beepnl/beep-base-firmware/2022_10_14_BeepBase_V1.5.12/README.md

BEEP base 1.5.12 adds a fix for the timing between lora network connection attempts, fixing excessive battery drain when the lora network is unavailable. It also contains a fix for updating the BEEP base firmware by older Android phones.
