beepnl/beep-base-firmware/2020_10_12_BeepBase_V1.5.2/ReadMe.txt

2020_10_12 Release van versie 1.5.2
	Oude BLE commandos van 1.4.2 voor de tilt sensor configuratie hersteld en de BLE aan/uit en reedswitch commando's aangepast naar andere waardes.
	Tilt en reed switch commando's om de applicatie aan en uit te kunnen schakelen zijn nu gesplits naar aparte commando's.
	
		Terug:
		19d/0x13 - READ_SQ_MIN_STATE: bit[0]:1=uit, 0=aan
		147d/0x93 - WRITE_SQ_MIN_STATE
		
		Aangepast:
		READ_ONOFF_CONTROL is nu READ_REED_STATE  	  38d/0x26  bit[0]:1=uit, 0=aan
		WRITE_ONOFF_CONTROL is nu READ_ONOFF_CONTROL  166d/0xA6  bit[0]:1=uit, 0=aan
		READ_ON_STATE 39/0x27	 bit[0]:0=uit, 1=aan
		WRITE_ON_STATE 167/0xA7	 bit[0]:0=uit, 1=aan  
	
	Nog een fout gevonden in de firmware versie naar uint32_t conversie die enkel de major revisie gebruikte in plaats van ook de minor en sub revisie getallen.
		Hierdoor is het updaten met minor of sub revisies mogelijk eerder niet altijd correct gegaan, maar bij major revisies wel. Deze fout zat al heel lang in
		de code.

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
