beepnl/beep-base-firmware/2021_03_30_BeepBase_V1.5.6/ReadMe.txt

2021-03-30 Releas van versie 1.5.6
	-	Read flash commando 0x22 geeft nu status 0xE0F/3599d (End Of File) als response als het flash compleet is uitgelezen. Vorrheen was dit NRF_SUCCESS 0x0 Dit had ik gewijzigd
		tijdens het testen, omdat er een probleem was met herhalende response codes en er op verschillende plekken in de code de NRF_SUCCESS kon worden gegenereerd.
	
	-	BLE MTU size wordt nu door de BEEP karakteristiek gebruikt om de grote van een BLE bericht te limiteren, zodat het uitlezen van het flash niet standaard de maximale MTU size 
		gebruikt. Hierdoor zou het onder IOS nu ook goed moeten werken. Ik kon niet verder testen dan dat de MTU size goed stond, aangezien de nRF Connect app op IOS compleet andere
		logs genereerd.
		
	-	De Beep control point gebruikt nu een Queue. Hiermee worden berichten die naar de smartphone moeten worden gestuurd tijdelijk gebufferd. De queue kan maximaal
		4 berichten bufferen. Hiermee is het probleem dat er onder sommige situaties een vorige response code wordt herhaald verholpen.
		
	-	Flash clear commando 0x2100 werkt nu correct. Het flash wordt na het wissen opnieuw geinitialiseerd. Het flash reageerd hierna weer correct op commando's 0x22(get flash size) 
		en 0x20(read flash).

2021-03-15 Release van versie 1.5.5.
	-	Optimalizatie van de flash applicatie statemachine verlaagd waardoor het flash uitlezen ook correct werkt onder release builds. Bij eerdere firmware releases stopte de 
		statemachine doordat er een boolean werd gewist na een specifiek aantal berichten. Hiervoor geen duidelijke oorzaak gevonden dan dat met een lager optimalizatie niveau
		dan optimize for size het probleem niet meer optreed.
	
2021-03-12 Release van versie 1.5.4.
	-	Om de log uit te lezen moet een power reset niet meer nodig zijn.
	
	-	TX karakteristiek hoeft nu niet meer notificatie uit->aan te worden gezet als er wordt verbonden met een gebond apparaat. De notificatie staat wordt dan uit de 
		BLE stack gehaald.
	
	-	Als een flash commando niet wordt uitgevoerd, wordt er nu een error code terug gestuurd:
			NRF_ERROR_INVALID_STATE		Als de TX notificaties niet aan staan voor het uitlezen van het MX flash.
			NRF_ERROR_BUSY				Als de flash applicatie statemachine bezig is met een vorig commando.
			NRF_ERROR_INVALID_ADDR		Als er een invalide flash commando wordt gegeven.
		Dit moet ook voorkomen dat als het flash niet wordt uitgelezen en er geen staat of error code terug wordt gestuurd de BLE in een staat komt waarbij er geen nieuwe 
		berichten meer worden afgehandeld. Aan de smartphone kant resulteerde dit in de nRF connect App in GATT ERROR 128: No resources
		
	-	Ik kan met een kleine log file van 16879 bytes dit correct uitlezen en het aantal bytes komt overeen met de flash size die wordt uitgelezen met commando 0x22

2021_02_02 Release van versie 1.5.3
	Hotfix voor BLE commando om het flash uit te lezen, wat niet wilde starten vanwege compiler optimalisatie. Met logging aan werkte dit wel naar behoren. 

2020_10_12 Release van versie 1.5.2
	Oude BLE commandos van 1.4.2 voor de tilt sensor configuratie hersteld en de BLE aan/uit en reedswitch commando's aangepast naar andere waardes.
	Tilt en reed switch commando's om de applicatie aan en uit te kunnen schakelen zijn nu gesplits naar aparte commando's.
	
		Terug:
		19d/0x13 - READ_SQ_MIN_STATE: bit[0]:1=uit, 0=aan
		147d/0x93 - WRITE_SQ_MIN_STATE
		
		Aangepast:
		READ_ONOFF_CONTROL is nu READ_REED_STATE  	  38d/0x26  bit[0]:1=uit, 0=aan
		WRITE_ONOFF_CONTROL is nu READ_ONOFF_CONTROL  166d/0xA6  bit[0]:1=uit, 0=aan
		READ_ON_STATE 39/0x27	 bit[0]:0=uit, 1=aan
		WRITE_ON_STATE 167/0xA7	 bit[0]:0=uit, 1=aan  
	
	Nog een fout gevonden in de firmware versie naar uint32_t conversie die enkel de major revisie gebruikte in plaats van ook de minor en sub revisie getallen.
		Hierdoor is het updaten met minor of sub revisies mogelijk eerder niet altijd correct gegaan, maar bij major revisies wel. Deze fout zat al heel lang in
		de code.

2020_10_08 Release van versie 1.5.1
	Tilt schakelaar functionaliteit terug gebracht en opstart logic aangepast aan de combinatie van reedswitch en tilt switch.
		Nieuw BLE commando's READ_ONOFF_CONTROL (0x26) en WRITE_ONOFF_CONTROL toegevoegd (0xA6), waarmee de reedswitch en til switch ingesteld kunnen worden. Standaard
		staat na het programmeren met 1.5.1 of via DFU van een oudere versie altijd de reedswitch aan. Met de ONOFF_CONTROL commando's kan de reedswitch of de tilt switch
		worden ingesteld. 
	
		Beide tegelijkertijd kan ook, maar beveel ik niet aan, aangezien de aan-uit staten dan niet meer kloppen of conflicteren. De tilt sensor is dominant bij het bepalen 
		van de aan/uit staat. Bijvoorbeeld met de reedswitch de BEEPBASE inschakelen wanneer deze verticaal staat gaat goed totdat er een oriëntatie wijziging plaatst vindt 
		die door de tilt schakelaar wordt gemeten. Als de BEEPBASE wordt uitgeschakeld wanneer deze horizontaal is, zal de BEEPBASE weer actief worden wanneer die ontwaakt 
		door een kleine trilling gemeten met de tilt sensor.
		
		De reedswitch kan nog wel worden bekrachtigd om BLE adverteren te starten of de pincode te resetten wanneer de reedswitch is uitgeschakeld om de applicatie aan of 
		uit te schakelen.
	
	Het inschakelen met de reedswitch duurt nu nog maar 3 seconden in plaat van 10.

2020_09_16 Release van Versie 1.5.0
	SQ-MIN-645B Tiltschakelaar functionaliteit verwijderd, omdat die niet meer op de hardware zit voor de volgende productie batches.
		In en uitschakelen van de BEEP applicatie kan nu met de reedswitch worden uitgevoerd. Door de reedswitch voor 10 seconden te bekrachtigen kan de BEEPBASE aan of uit worden gezet
		met audio feedback voor de gebruiker. Elke seconde wordt er een pieptoon gemaakt met de buzzer die op of afloopt que frequentie, totdat die driemaal piept. Als de magneet dan
		wordt verwijderd veranderd de BEEPBASE van staat met de reeds bekende pieptonen. 
		Via BLE of LoRaWAN kan de BEEPBASE ook worden uitgezet met commando READ_ON_STATE 0x13 en WRITE_ON_STATE 0x93, voorheen gebruikt om de SQ-MIN-645B functionaliteit in of uit te
		schakelen.
	De bootloader activatie tijdens een reset met de reedswitch is nu uitgeschakeld, omdat de bootloader continue activeerde bij elke poging om de applicatie te starten van uit-staat.
	Epoch tijd toegevoegd, deze werkt enkel wanneer de BEEPBASE aanstaat. In de uitstaat zijn alle timers en klokken uitgeschakeld en kan de tijd niet bijgehouden worden.
		De tijd kan gelezen en geschreven worden via BLE of LoRaWAN en wordt ook als een parameter toegevoegd aan alle logs. READ_TIME 0x25, WRITE_TIME 0xA5.
		Als de tijd wordt gewijzigd wordt er een extra bericht gelogd in het flash met de oude en nieuwe tijd instellingen.
		Standaard staat de Epoch tijd op 0.
		Om de 48 uur wordt de tijd ook opgeslagen in het flash van de nRF als er niet eerder een flash opslag plaats vindt.
	Als de BEEPBASE wordt geprogrameerd staat deze altijd uit. Bij een firmware update is de BEEPBASE aan-staat altijd aan.
	Opstart logica is aangepast, omdat de tilt-schakelaar de nRF niet meer wakker kan maken door trillingen en orientatie wijzigingen.
	Documentatie is bijgewerkt aan bovenstaande aanpassingen.

2020_06_05 Release van Versie 1.4.2
	LoRaWAN offtime voor KPN netwerk verbeterd. De tijd berekening was niet correct wanneer de app_timer's RTC1 overflowde.

2020_06_02 Release van Versie 1.4.1
	LoRaWAN send functie gebruikte een verkeerde bericht lengte om te controleren of dat de MAC buffer verstuurd moest worden. Bij KPN LoRaWAN netwerk gaf dit problemen, omdat de MAC buffer niet
	werd verstuurd, maar er werden ook geen LoRaWAN berichten verstuurd.

2020_05_19 Release van Versie 1.4.0
	Commando geimplementeerd om de SQ-200-MIN orientatie bepaling in of uit te schakelen. Met commando READ_SQ_MIN_STATE (19d/0x13) en WRITE_SQ_MIN_STATE (147d/0x93) kan de SQ orientatie worden uitgeschakeld door bit 0 op 1 te 
	zetten. Alle andere bits worden wel opgeslagen, maar hebben geen verdere functie.

2020_02_26 Release van Versie 1.3.5
	De DS18B20 communicatie fout teller wordt nu gereset bij een nieuwe staat of conversie start. Voorheen gebeurde enkel na het succesvol uitlezen van de temperatuur. Dit had als gevolg dat als een DS18B20 
	meer dan 5 communicatie fouten had, dan stopte de sensor met meten bij oudere firmware.
	
	Bij de conversie start wordt nu de laatst gemeten temperatuur op -100.0 gezet, dus als de sensor niet uitgelezen kan worden zal die waarde worden verstuurd met LoRaWAN in plaats van de laatst gemeten waarde.

2020_01_28 Release van Versie 1.3.4
	READ_APPLICATION_CONFIG data toegevoegd aan het opstart bericht.
	
	Een minuut na het succesvol verbinden met het LoRaWAN netwerk wordt het opstart bericht verstuurd. Mocht dit niet lukken in verband met de duty cycle wordt dit 
		een minuut later opnieuw geprobeerd.

2020_01_28 Release van Versie 1.3.3
	Standaard bericht interval is nu 15 minuten in plaats van 1 minuut.
		Dit betekend wel dat reeds geprogrameerde sensoren die niet worden gewist en opnieuw worden geprogrameerd met de hexfile, bijvoorbeeld met DFU nog steeds de 
		standaard interval van 1 minuut hebben na het updaten naar 1.3.3.
	
	Opstart bericht met FPORT waarde 2 (BEEP_SENSOR_ON) wordt nu weer na het opstarten en joinen van het netwerk verstuurd.

2020_01_06 Release van Versie 1.3.2
	Fix voor de BME280 die niet correct werkte en daardoor continue hetzelfde resultaat terug gaf. 
	
	> Pim had een probleem met de tilt sensor gerapporteerd, die niet werkte als de BEEPBASE voor langere tijd stil lag. Dit heb ik zelf niet kunnen reproduceren met de print vanuit China.
		Ook niet over periodes van enkele dagen.

2019_12_23 Release van Versie 1.3.1
	Bericht interval gebruikt nu weer de normale vermenigvuldigingsfactor van 60 ipv de debug waarde van 20.

	BME280 statemachine verder uitgebreid met extra controles voor het geval dat er geen sensor is aangesloten.
	
	LoRaWAN dutycycle limitatie werkt nu en kan aan en uit gezet worden.
	
	LoRaWAN uitschakelen resette niet de LoRaWAN stack. Het wijzigen van de LoRaWAN configuratie met WRITE_LORAWAN_STATE reset nu altijd de LoRaWAN stack.
	
	De bericht ratio werkte niet naar behoren omdat de statemachine in dezelfde state bleef hangen en na een aantal iteraties toch een bericht verstuurde.
		Het eerste start-up bericht en downlink-response berichten negeren nu de bericht ratio en worden altijd verstuurd op het eerst volgende bericht interval.
		
	De tilt sensor op de nieuwe PCB's moet nu correct werken. De applicatie onthoud nu de laatste opstart staat. Als dit vertikaal was en de huidige orientatie is ook
		vertikaal dan is de BEEPBASE wakker geworden door een trilling en gaat de BEEPBASE direct naar SYSTEM OFF zonder buzzer geluid patroon.

2019_12_20 Release van Versie 1.3.0
	TLV Audio ADC toegevoegd met FFT functionaliteit.
		Alle drie de kanalen werken, zowel Links als rechts.
		Meet resultaat is toegevoegd aan de flash opslag en het LoRaWAN bericht.
	
	BME280 toegevoegd, meet temperatuur, luchtvochtigheid en luchtdruk
		Meet resultaat is toegevoegd aan de flash opslag en het LoRaWAN bericht.
	
	Flash log payload is nu binair ipv hexadecimaal. Nu is de payload de helft kleiner.
	
	ERASE_MX_FLASH heeft nu een extra parameter waarmee twee opties kunnen worden geselecteerd; Erase fatfs log of Erase MX chip 
	
	BLE command toegevoegd:
		- BME280_CONVERSION_READ
		- BME280_CONVERSION_START
		- READ_AUDIO_ADC_CONFIG
		- WRITE_AUDIO_ADC_CONFIG
		- READ_AUDIO_ADC_CONVERSION
		- START_AUDIO_ADC_CONVERSION
		- ALARM_CONFIG_READ
		- ALARM_CONFIG_WRITE
		- ALARM_STATUS_READ
		
	Problemen met random resets in combinatie met de Nordic Power Profiler komen doordat de ingangspanning te hard daalt waneer er een LORaWAN bericht wordt verstuurd.
		Voor testen met de Nordic PKK is het aan te bevelen om de diode die aan de ingang zit te verwijderen of met een kabel te overbruggen.
		
	Firmware handleiding 1.3 staat nu op Google drive

2019_12_03 Release van Versie 1.2.2
	Fix voor het probleem met nieuwere smartphones die geen pin-code pop-up krijgen, omdat de encryptie mislukt.

2019_12_02 Release van Versie 1.2.1
	Recompile van release 1.2.0, maar dan zonder Pin code. Blijkt dat dit toch niet correct werkt op andere devices dan waar ik op heb getest.

2019_11_29 Release van Versie 1.2.0
	Flash logging toegevoegd voor meet data met als basis de Image Transfer voorbeeld: https://github.com/NordicPlayground/nrf52-ble-image-transfer-demo
		Voor de app ontwikkeling kan ook nog naar deze link worden gekeken: https://github.com/NordicPlayground/Android-Image-Transfer-Demo
		De snelheid is niet bepaald hoog met nRF Connect op een S5, maar dit komt grotedeels door de lage interval connectie en de MTU grote. Op mijn S5 wil het OS geen andere
		parameters instellen dan de instellingen bij het verbinden. De developer(https://devzone.nordicsemi.com/f/nordic-q-a/47503/bluetooth-5-0-file-transfer) van de OTS service zegt 
		snelheden te hebben behaald van 1200kbps, dus misschien dat er vanuit de App meer mogelijk is dan dat ik vanuit de peripheral kan behalen qua connectie interval.
		Ik heb wel de MTU standaard op 240 btes gezet ipv 23, omdat het onderhandelen met de client (S5 met nRF Connect) niks opleverde.
		
	BLE commands toegevoegd voor de Bootcount, FLASH_READ, FLASH_ERASE, FLASH_SIZE
	
	TX karakteristiek toegevoegd aan de BEEP service.
	
	Uitlezen van het flash log via de Beep control point en TX data karakteristiek
	
	Pincode bescherming aangezet. Pincode kan worden gereset door de reedswitch voor 30 seconden te bekrachtigen. De BEEPBASE geeft een pieptoon als deze is gereset.
		Dit betekend ook dat bonding nu verplicht is. Als een van de twee devices een vorige bond is vergeten kan dit een aantal pogingen kosten voordat de pincode pop-up komt. Als
		Encryptie mislukt op de BEEPBASE wordt de conenctie verbroken. Dit houdt in dat het verbinden een aantal keer herhaald moet worden voordat of de bestaande bond eerst gewist
		moet worden.
		Het bekrachtigen van de reedswitch wist alle bonden op de BEEPBASE.

2019_11_11 Release van Versie 1.1.1
	Release 1.1.1 gemaakt met de buzzer geactiveerd in firmware en een extra default tune op index 2. Beep protocol commando: 0x9102
	Programeer script aangepast zodat deze niet langer verwacht dat de hex file in een map genaamd "release staat."
	Firmware release 1.1.0 voor het gemak toegevoegd, aangezien die bijna gelijk is.
	Het probleem van de ontbrekende DS18B20 temperatuur in de LoRaWAN berichten was heel simpel: De decoder verwachte meer bytes dan er nog in het bericht aanwezig waren en stopte met decoderen.
	De temperatuur zat dus wel in het LoRaWAN bericht, maar in alle haast zag ik het DS18B20 READ commando niet in het hexadecimale bericht.

2019_11_04 Release van versie 1.1.0
	Eerste release van firmware.
	Bij verdere releases zal in dit document veranderingen worden bijgehouden.
	Beep Base Handleiding ge-update naar aanleiding van wijzigen van HX711 read and Write conversion command, HX711 state R/W command toegevoegd, Buzzer custom en default tune commands toegevoegd.

2019_11_01
	Vrijgave Beep Base handleiding 1V0
