beepnl/beep-base-firmware/Source_V1.5.14/Datasheets/CUI_SJ-43514.step

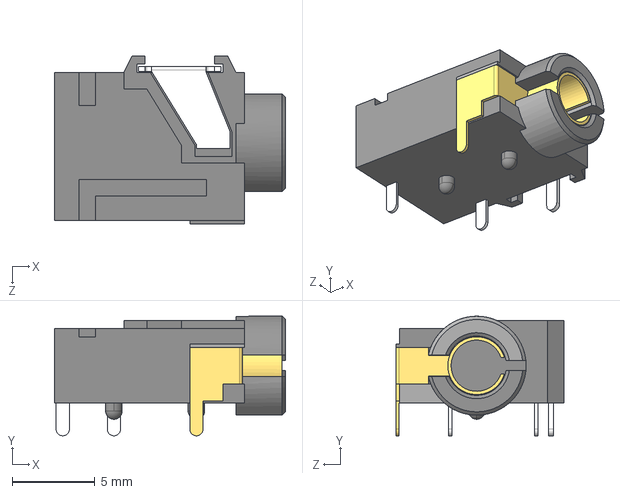
[picture p8: CAD file, 2022-09-14, an earlier design]
Source_V1.5.14/Datasheets/CUI_SJ-43514.step
14.0 x 7.25 x 10.2 mm
