beepnl/beep-base-firmware/Source_V1.5.14/Docs/ID190222-01_Schematic_201907231028.pdf

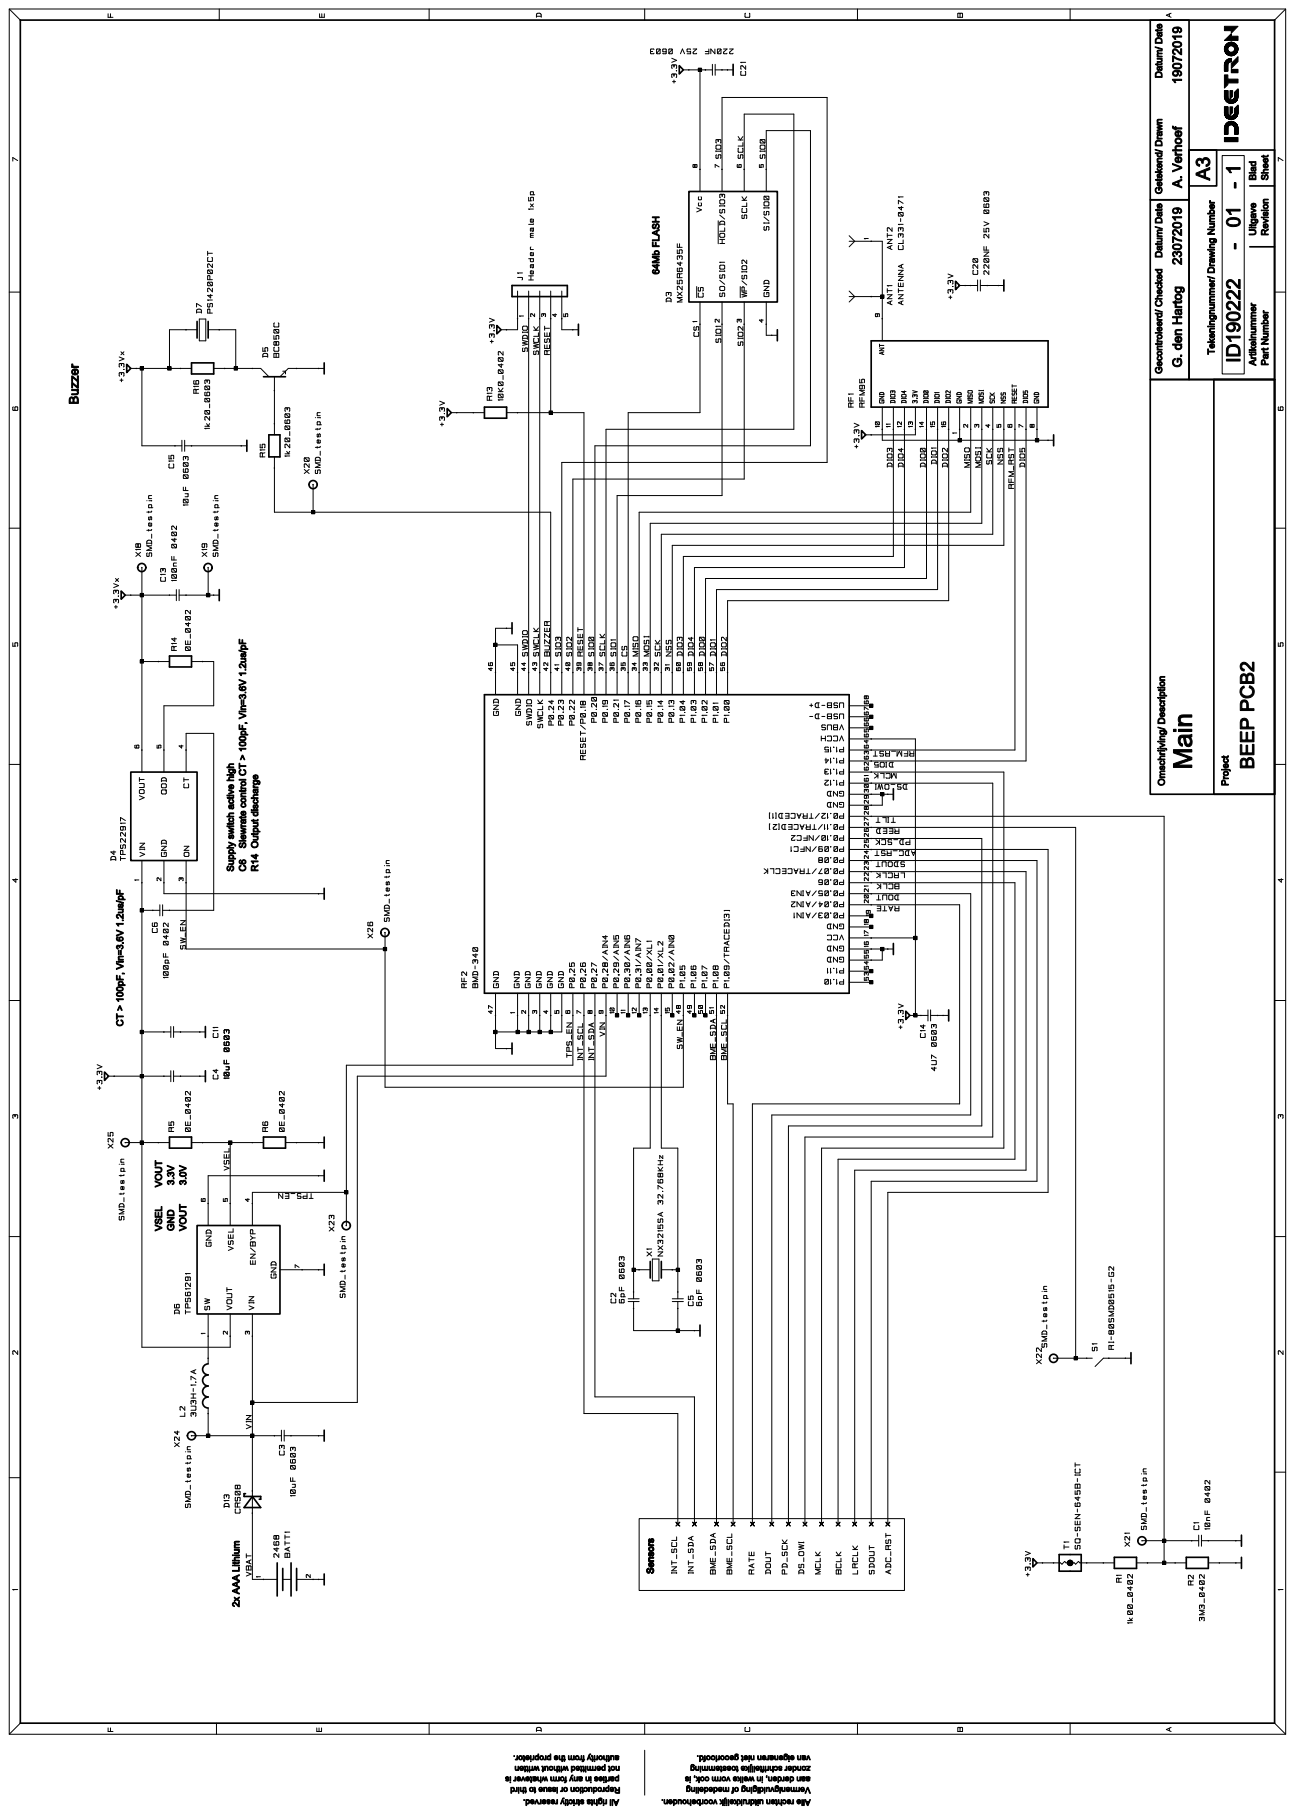
[picture p14: page 1]

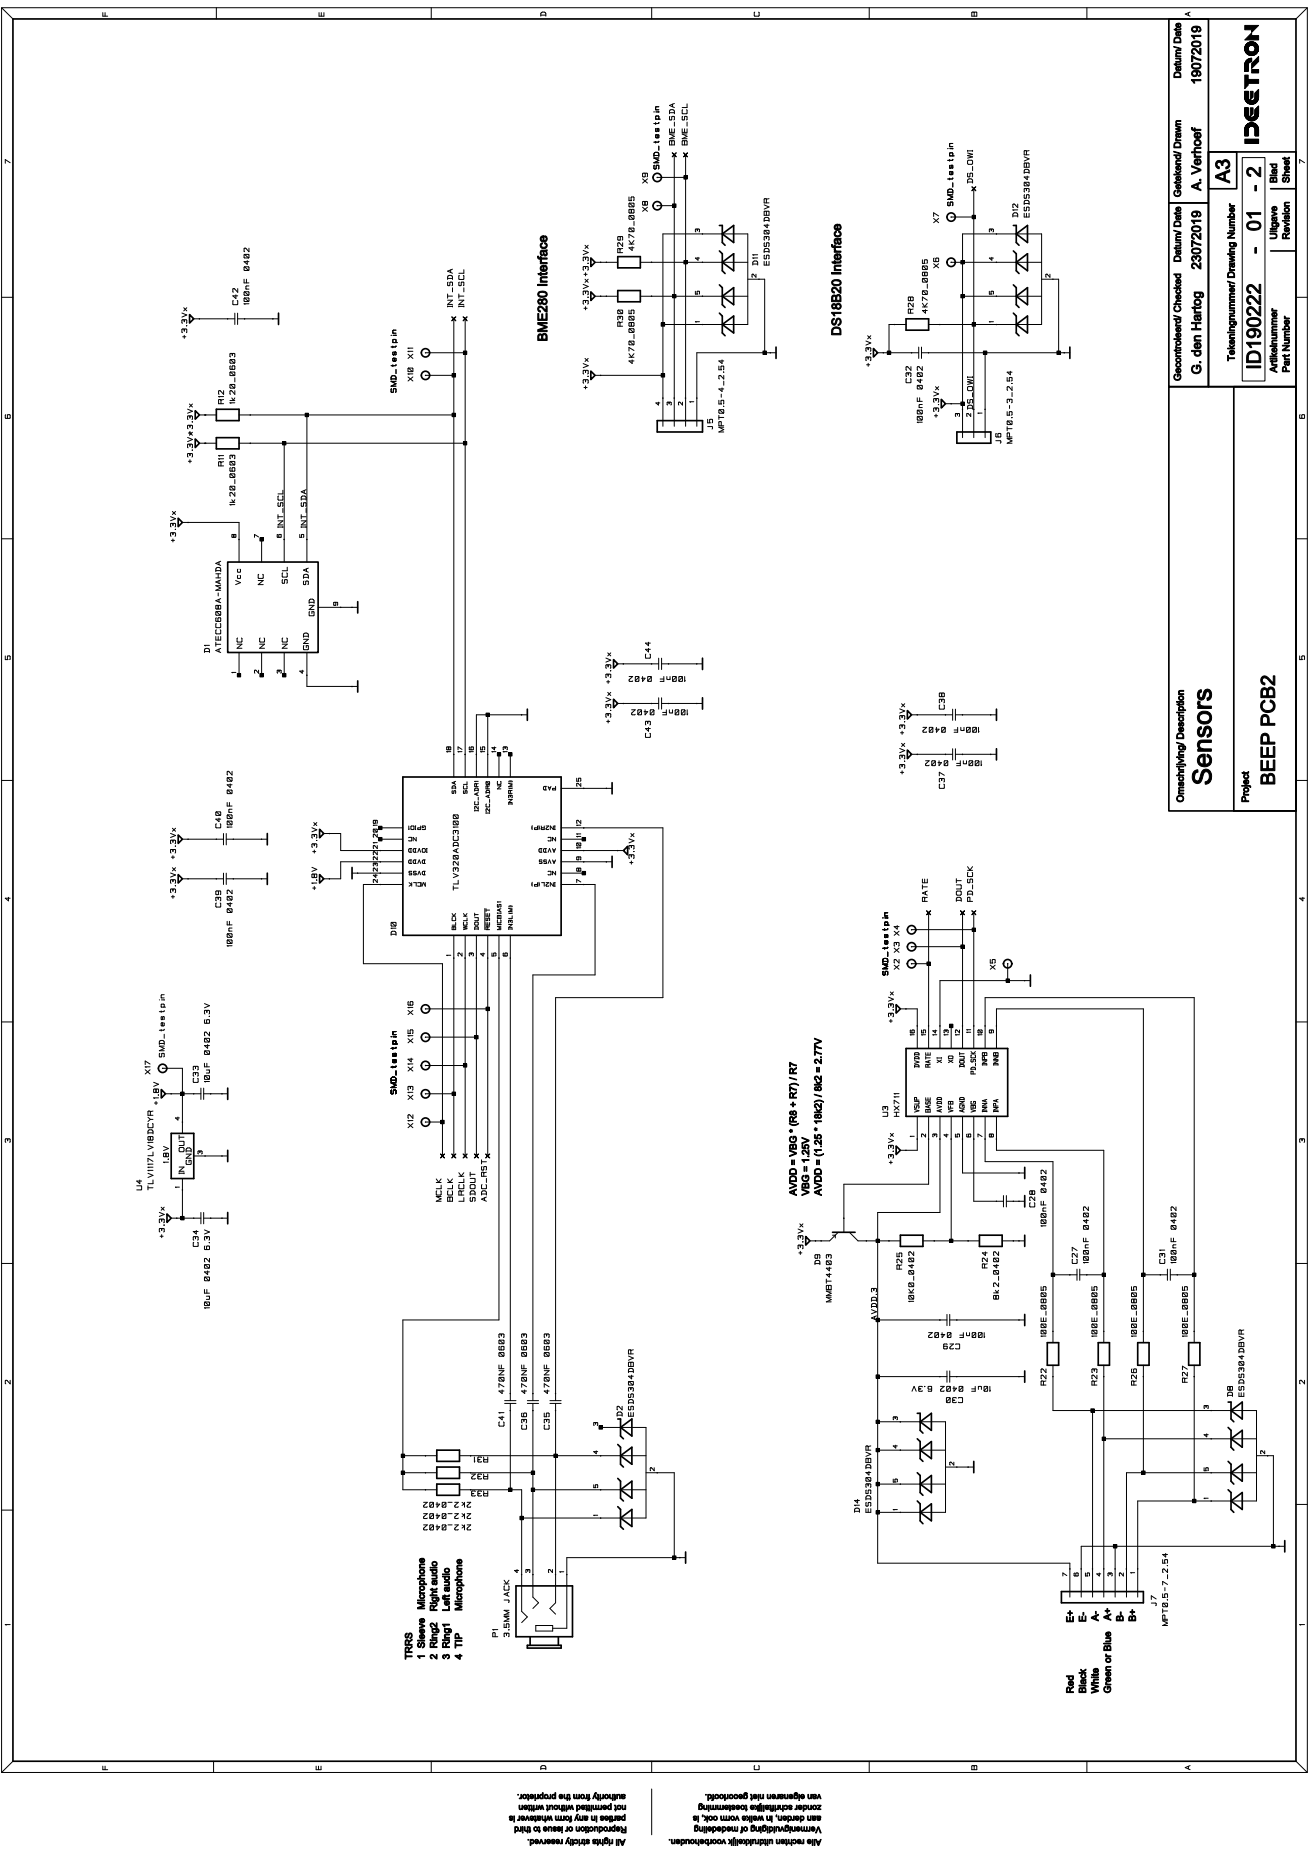
[picture p15: page 2]
