beepnl/beep-base-firmware/(commit log)

2022-01-14 Update available firmware versions
    [config.txt]
2022-01-14 Remove ignored files
    [config.txt]
2022-08-24 Add firmware V1.5.11 source code
    [BreakDownUren.xlsx, CUI_SJ-43514.step, beepDataStorage.xlsx, config.txt]
2022-08-24 Add firmware V1.5.12 src
    [BreakDownUren.xlsx, CUI_SJ-43514.step, beepDataStorage.xlsx, config.txt]
2022-08-24 Switch branch 'master' to branch 'circularLogging'
    [BreakDownUren.xlsx, CUI_SJ-43514.step, beepDataStorage.xlsx, config.txt]
2022-08-24 Add firmware v1.5.11 source (branch 'circularLogging')
    [BreakDownUren.xlsx, CUI_SJ-43514.step, TLV320adc3100_calc.xlsx, TLV320adc3100_calc_8kHz.xlsx, beepDataStorage.xlsx, config.txt, nRF52_FFTresult.xlsx]
2022-08-24 Add v1.5.12 source
    [BreakDownUren.xlsx, CUI_SJ-43514.step, TLV320adc3100_calc.xlsx, TLV320adc3100_calc_8kHz.xlsx, beepDataStorage.xlsx, config.txt, nRF52_FFTresult.xlsx]
2022-09-14 Increased DFU connection interval to fix GATT timeout error
    [sdk_config.h]
2023-03-10 i2c driver for maxim DS3231 rtc
2023-03-15 add event handler
    [BreakDownUren.xlsx, CUI_SJ-43514.step, TLV320adc3100_calc.xlsx, TLV320adc3100_calc_8kHz.xlsx, beepDataStorage.xlsx, config.txt, nRF52_FFTresult.xlsx]
2023-04-13 ds3231 time set/get + pull-up fix
    [ds3231_app.c, ds3231_app.h]
2023-04-18 initial timestamping & setting ds3231 status/control registers to keep clock oscillator running on battery
    [beep_types.h, ds3231_app.c, ds3231_app.h, gpio-board.c, main.c, sdk_config.h]
2023-04-18 fix setting OSF bit in status register
    [ds3231_app.c]
2023-04-18 fix operator precendence in bcd2dec & dec2bcd
    [ds3231_app.c]
2023-04-18 fix for passing the time more correctly to mktime()
    [ds3231_app.c]
2023-04-26 disable the I2C instance and disable pull-ups on pins if no DS3231 is detected
2023-04-26 start clock oscillator only if I2C instance is initialized
    [ds3231_app.c]
2023-05-02 keep track of whether the DS3231 time has already been set over bluetooth
2023-05-02 fix call to nvm_ds3231_set_ble_initialized() with invalid argument
    [main.c]
2023-05-15 revert changes to flash_struct_s
    [nvm_fs.c, nvm_fs.h]
2023-05-15 change ds3231 initialization logic & mktime() fix
    [ds3231_app.c, ds3231_app.h, main.c, main.h, sdk_config.h]
2023-05-17 disable logtime_callback minute timer if DS3231 is enabled & fix WRITE_TIME command
    [beep_protocol.c, beep_protocol.h, ds3231_app.c, log_time.c, main.c, sdk_config.h]
2023-05-17 fix for READ_TIME command (BLE)
    [main.c]
2023-05-17 change to non-blocking mode & add checks for Enable Oscillator (EOSC) and Oscillator Stop Flag (OSF) bits
    [ds3231_app.c]
2023-05-20 fix scan for DS3231
    [ds3231_app.c, ds3231_app.h, main.c, sdk_config.h]
2023-05-22 fix READ_TIME BLE command
    [ds3231_app.c, ds3231_app.h, log_time.c, main.c, sdk_config.h]
2023-05-23 Add monitor-mode script -- without this the Softdevice will crash when debugging (halting/stepping) while bluetooth is active
    [main.c]
2023-05-24 Fix apptimer periodically resetting logtime when DS3231 is not connected
    [log_time.c]
2023-06-02 add image to README of the DS3231 module connected to the I2C screw terminal
2023-07-31 Add v1.5.13 DFU build scripts with fixes from user feedback + finish merge of external-RTC branch (v1.5.13) with main
    [BreakDownUren.xlsx, CUI_SJ-43514.step, TLV320adc3100_calc.xlsx, TLV320adc3100_calc_8kHz.xlsx, beepDataStorage.xlsx, nRF52_FFTresult.xlsx]
2023-08-18 Add RTC status to the payload & fix incorrect log_time.c and ds3231_app.c/h versions
    [beep_protocol.c, beep_protocol.h, ds3231_app.c, ds3231_app.h, log_time.c]
2023-08-18 Fix parentheses in payload's RTC status
    [beep_protocol.c]
2023-08-22 RTC status indicator added to payload and log file, version bump to v1.5.14
    [BreakDownUren.xlsx, CUI_SJ-43514.step, TLV320adc3100_calc.xlsx, TLV320adc3100_calc_8kHz.xlsx, beepDataStorage.xlsx, nRF52_FFTresult.xlsx]
2023-08-22 Set RTC status byte 0x26 in lora payload *and* in flashlog + unregister the I2C-2 driver when no DS3231 is found
2024-04-02 v1.5.15 (fixes for DFU, added RTC command identifier)
    [Buzzer.c, DS18B20.c, DS18B20_app.c, DS18B20_app.h, DS3231.c, DS3231.h, HX711.c]
